Zajda229/Arduino-zahradka/imges/Bluetooth.png

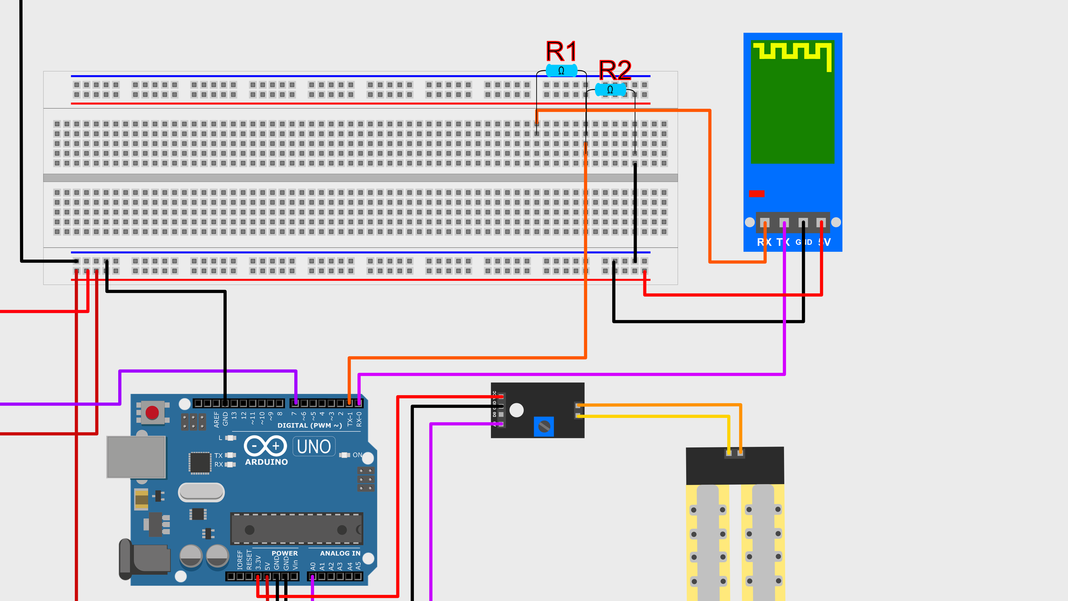
imges/Bluetooth.png
