Zajda229/Arduino-zahradka/imges/konecne_zapojeni.png

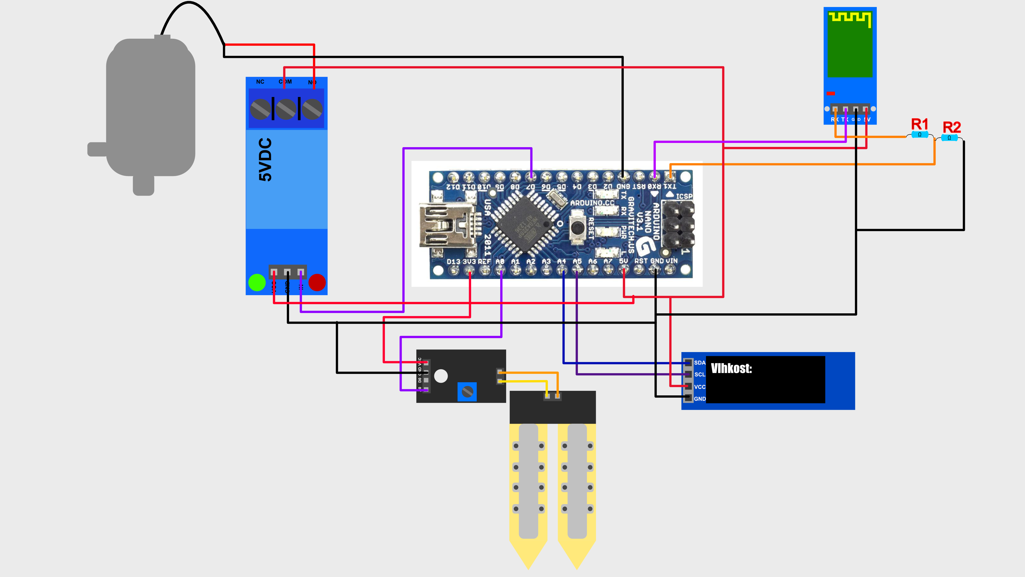
imges/konecne_zapojeni.png
