Zajda229/Arduino-zahradka/imges/pridani_rele.png

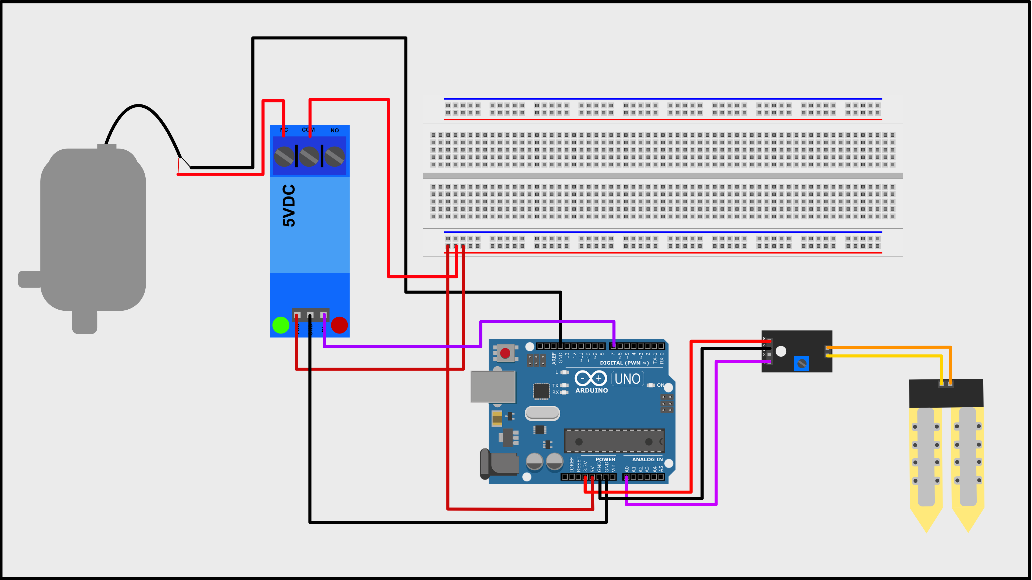
imges/pridani_rele.png
