Zajda229/Arduino-zahradka/imges/serizovani_hodnot.png

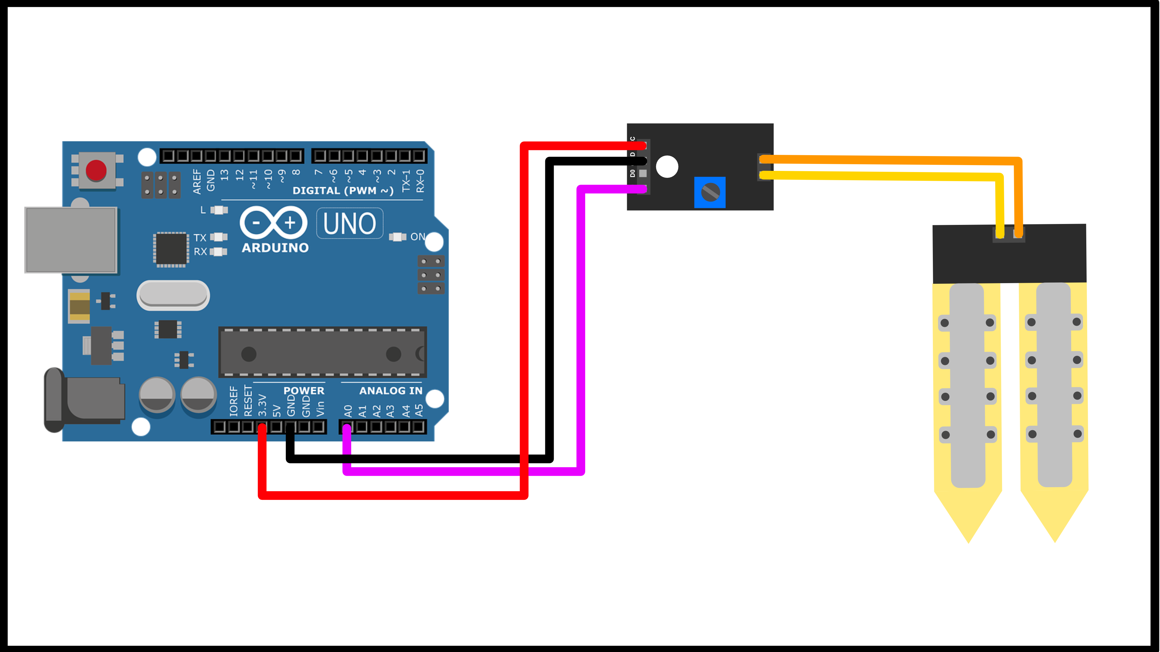
imges/serizovani_hodnot.png
